mlainez/midiboard/docs/render-3d.png

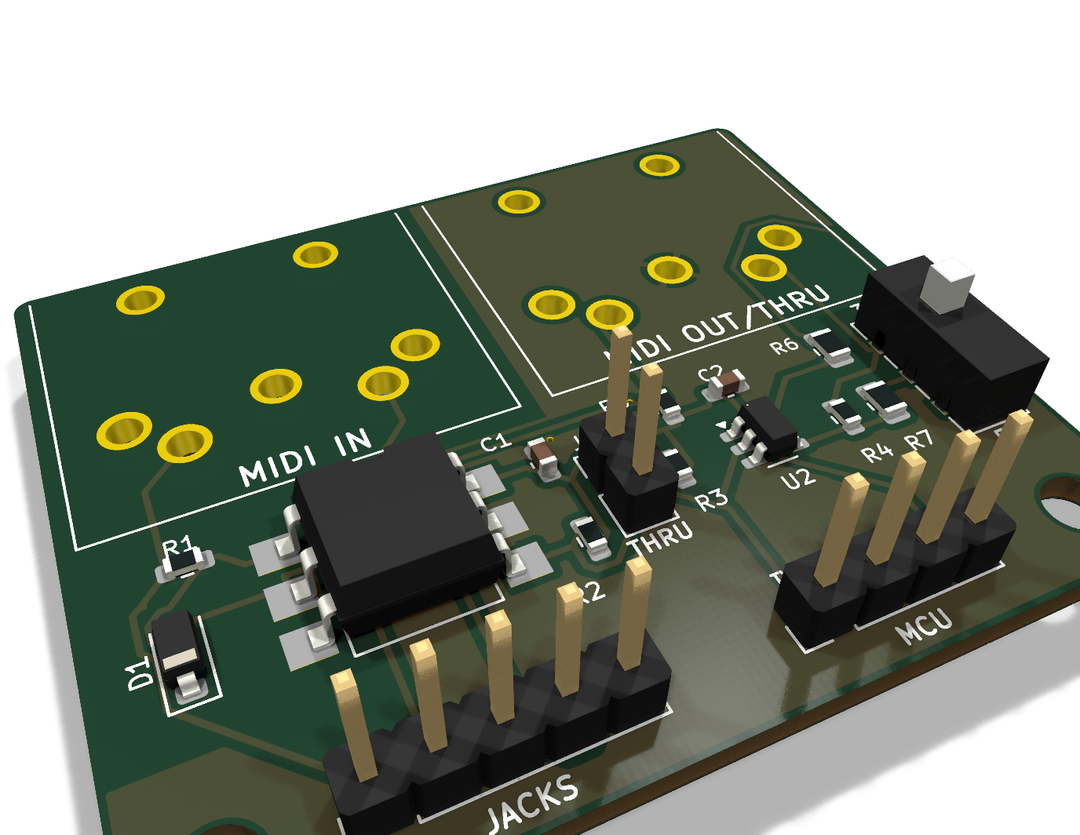
docs/render-3d.png
