mlainez/midiboard/docs/render-bottom.png

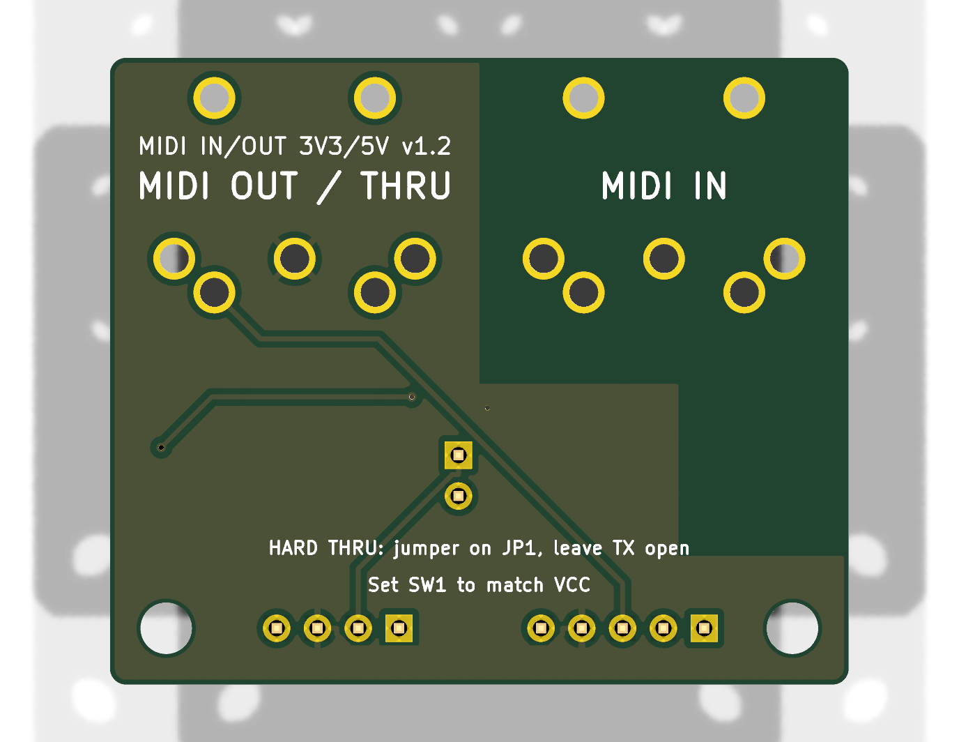
docs/render-bottom.png
