mlainez/midiboard/jlcpcb/midiboard-BOM.csv

Comment | Designator | Footprint | LCSC Part #
100nF | C1,C2 | C_0603_1608Metric | C14663
1N4148W | D1 | D_SOD-123 | C81598
220 | R1,R4,R5 | R_0603_1608Metric | C22962
470 | R2 | R_0603_1608Metric | C23179
10k | R3 | R_0603_1608Metric | C25804
33 | R6 | R_0805_2012Metric | C17634
10 | R7 | R_0805_2012Metric | C17415
3V3/5V | SW1 | SW_DPDT_CK_JS202011JCQN | C221665
H11L1SM | U1 | SMDIP-6_W9.53mm | C899473
74LVC1G17 | U2 | SOT-23-5 | C151394
