mlainez/midiboard/jlcpcb/midiboard-schematic.pdf

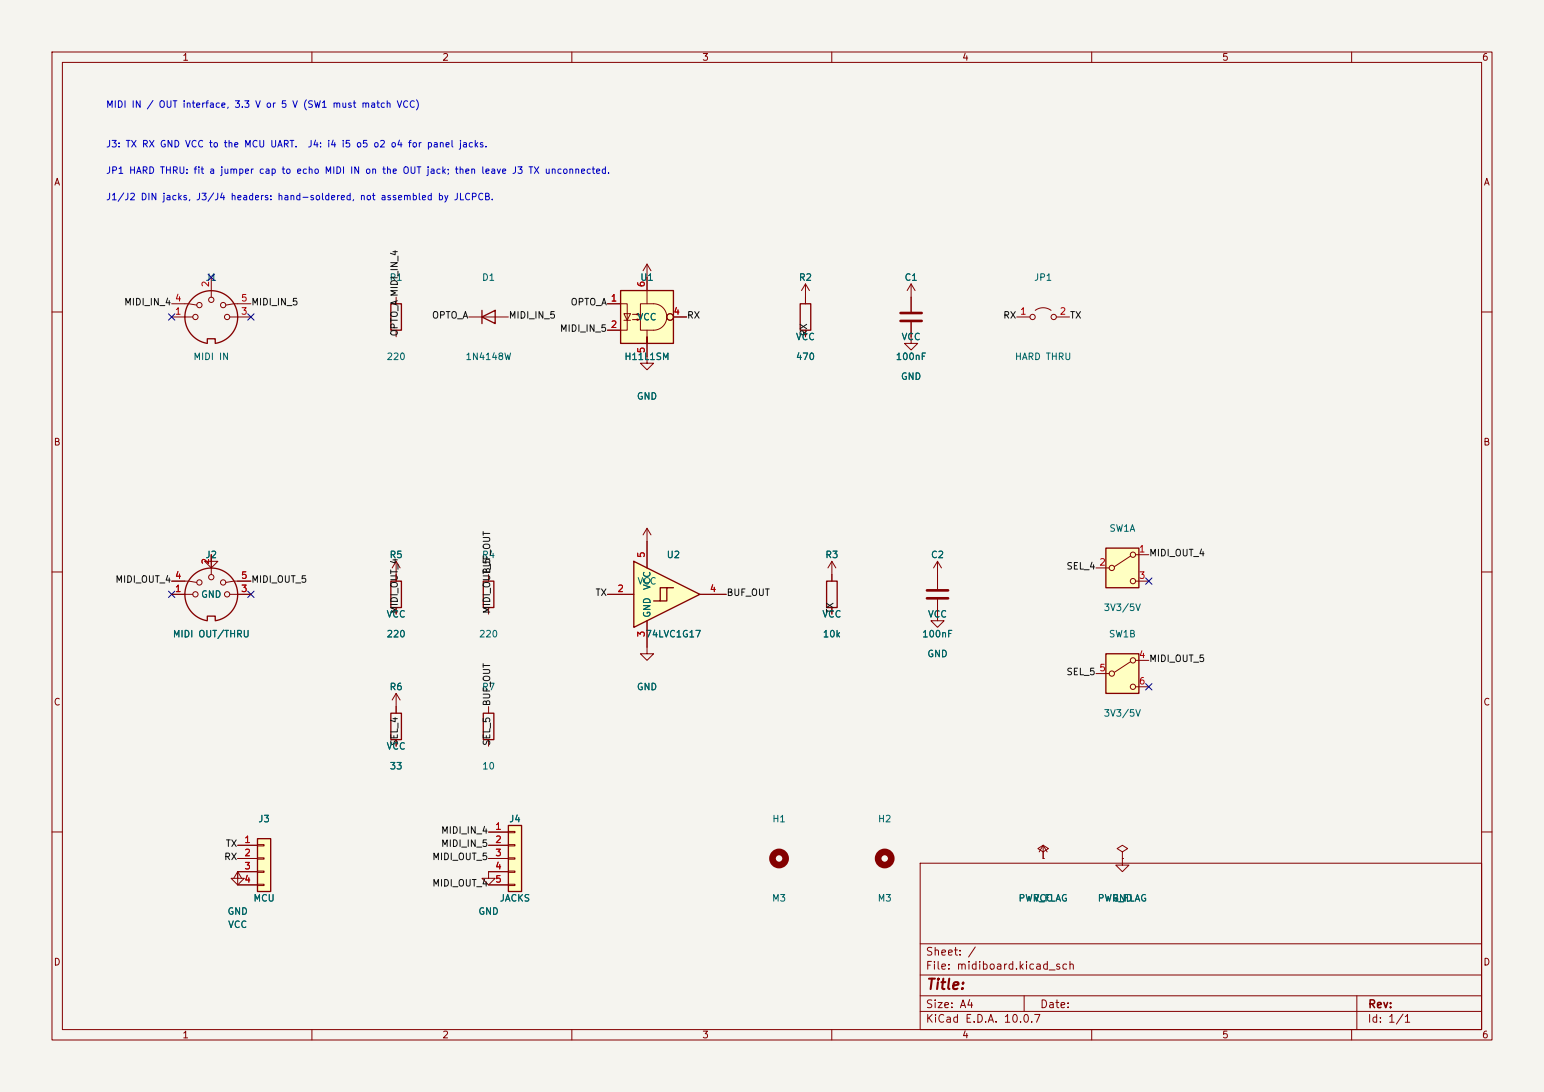
[picture p4: page 1]

TX MIDI IN / OUT interface, 3.3 V or 5 V (SW1 must match VCC) J3: TX RX GND VCC to the MCU UART. J4: i4 i5 o5 o2 o4 for panel jacks. JP1 HARD THRU: fit a jumper cap to echo MIDI IN on the OUT jack; then leave J3 TX unconnected. J1/J2 DIN jacks, J3/J4 headers: hand-soldered, not assembled by JLCPCB. J2 MIDI OUT/THRU

Size: A4 | Rev:
KiCad E.D.A. 10.0.7 | Id: 1/1
