mlainez/midiboard/midiboard.kicad_pcb

## KiCad design midiboard.kicad_pcb (2026-10-20)

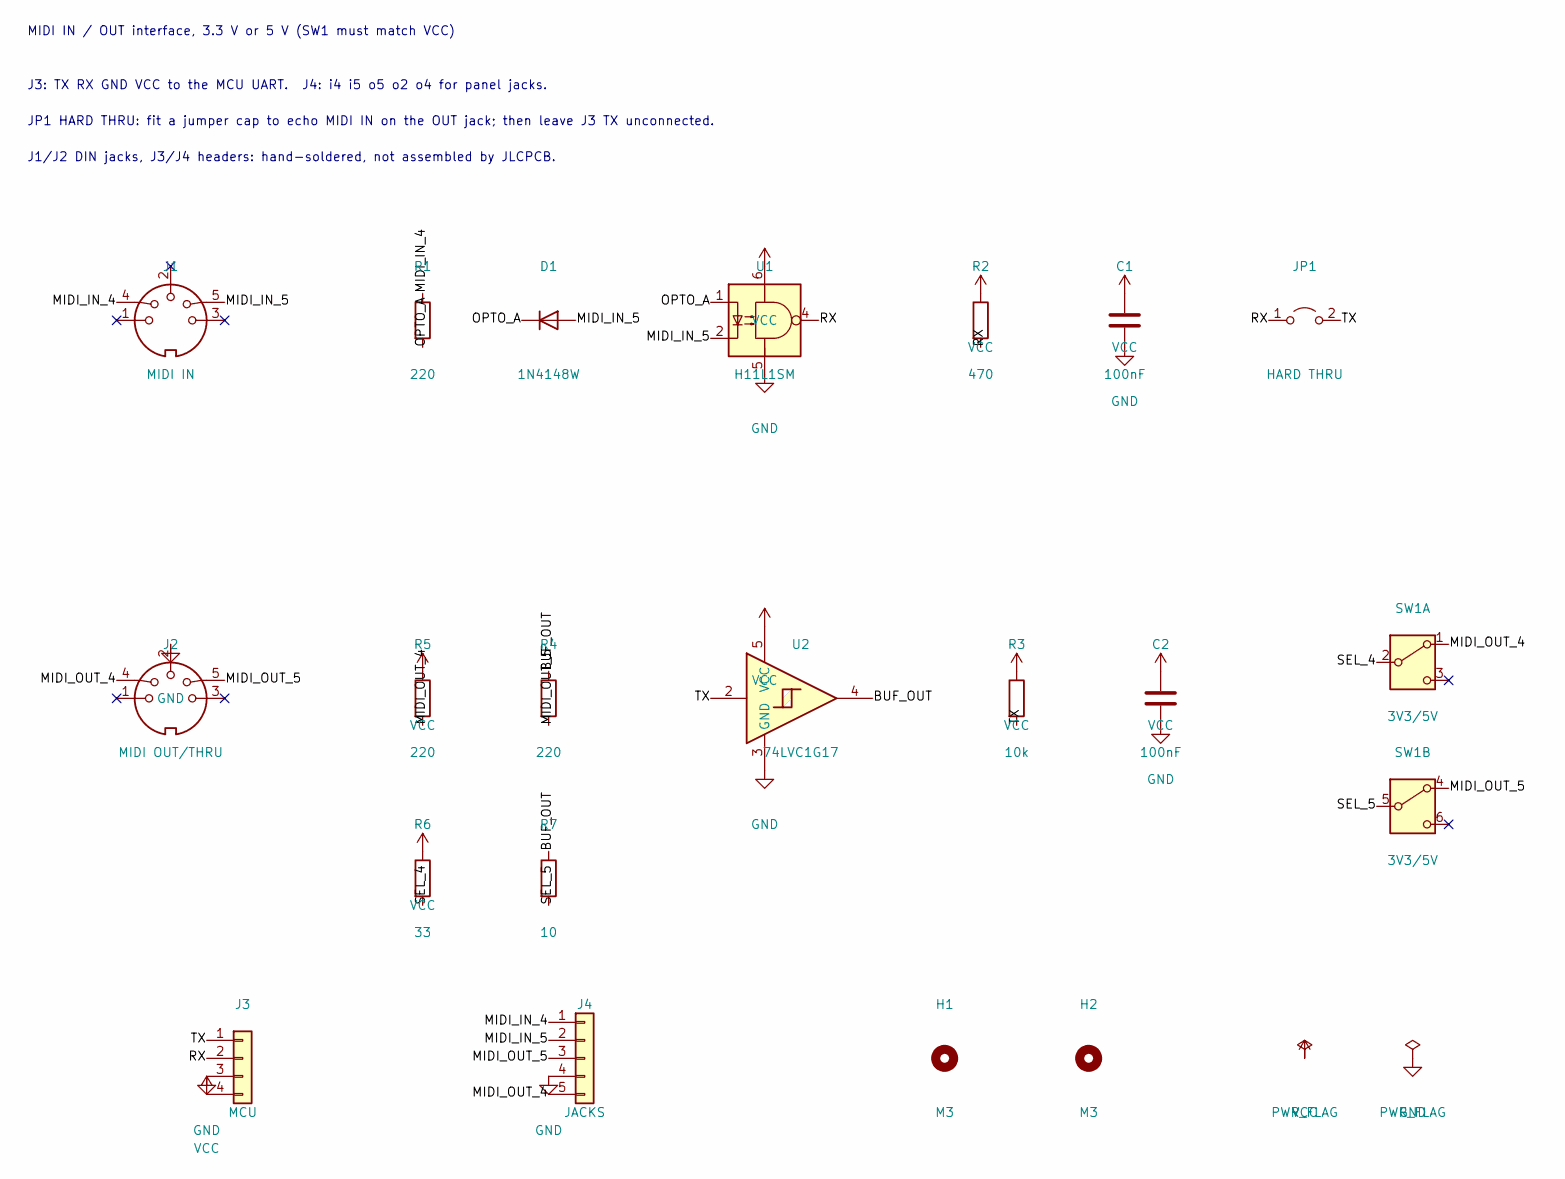
[picture p5: schematic midiboard.kicad_sch]

Parts:
C1, C2: 100nF; C_0603_1608Metric; MPN CC0603KRX7R9BB104; LCSC C14663
D1: 1N4148W; D_SOD-123; MPN 1N4148W; LCSC C81598
H1, H2: M3; MountingHole_3.2mm_M3
J1: MIDI IN; DIN-5_Female_Horizontal_DIN-504; MPN Legion DIN-504 (LCSC C23689428)
J2: MIDI OUT/THRU; DIN-5_Female_Horizontal_DIN-504; MPN Legion DIN-504 (LCSC C23689428)
J3: MCU; PinHeader_1x04_P2.54mm_Vertical; MPN 2.54mm pin header 1x4
J4: JACKS; PinHeader_1x05_P2.54mm_Vertical; MPN 2.54mm pin header 1x5
JP1: HARD THRU; PinHeader_1x02_P2.54mm_Vertical; MPN 2.54mm pin header 1x2 + jumper cap
R1, R4, R5: 220; R_0603_1608Metric; MPN 0603WAF2200T5E; LCSC C22962
R2: 470; R_0603_1608Metric; MPN 0603WAF4700T5E; LCSC C23179
R3: 10k; R_0603_1608Metric; MPN 0603WAF1002T5E; LCSC C25804
R6: 33; R_0805_2012Metric; MPN 0805W8F330JT5E; LCSC C17634
R7: 10; R_0805_2012Metric; MPN 0805W8F100JT5E; LCSC C17415
SW1: 3V3/5V; SW_DPDT_CK_JS202011JCQN; MPN C&K JS202011JCQN; LCSC C221665
U1: H11L1SM; SMDIP-6_W9.53mm; MPN onsemi H11L1SM; LCSC C899473
U2: 74LVC1G17; SOT-23-5; MPN Diodes 74LVC1G17W5-7; LCSC C151394

Connections:
/BUF_OUT: R4.1, R7.1, U2.4
/MIDI_IN_4: J1.4, J4.1, R1.1
/MIDI_IN_5: D1.2 (A), J1.5, J4.2, U1.2
/MIDI_OUT_4: J2.4, J4.5, R5.2, SW1.1 (A)
/MIDI_OUT_5: J2.5, J4.3, R4.2, SW1.4 (A)
/OPTO_A: D1.1 (K), R1.2, U1.1
/RX: J3.2, JP1.1 (A), R2.2, U1.4
/SEL_4: R6.2, SW1.2 (B)
/SEL_5: R7.2, SW1.5 (B)
/TX: J3.1, JP1.2 (B), R3.2, U2.2
GND: C1.2, C2.2, J2.2, J3.3, J4.4, U1.5, U2.3 (GND)
VCC: C1.1, C2.1, J3.4, R2.1, R3.1, R5.1, R6.1, U1.6, U2.5 (VCC)

Notes on the sheet:
MIDI IN / OUT interface, 3.3 V or 5 V (SW1 must match VCC)
J3: TX RX GND VCC to the MCU UART. J4: i4 i5 o5 o2 o4 for panel jacks.
JP1 HARD THRU: fit a jumper cap to echo MIDI IN on the OUT jack; then leave J3 TX unconnected.
J1/J2 DIN jacks, J3/J4 headers: hand-soldered, not assembled by JLCPCB.

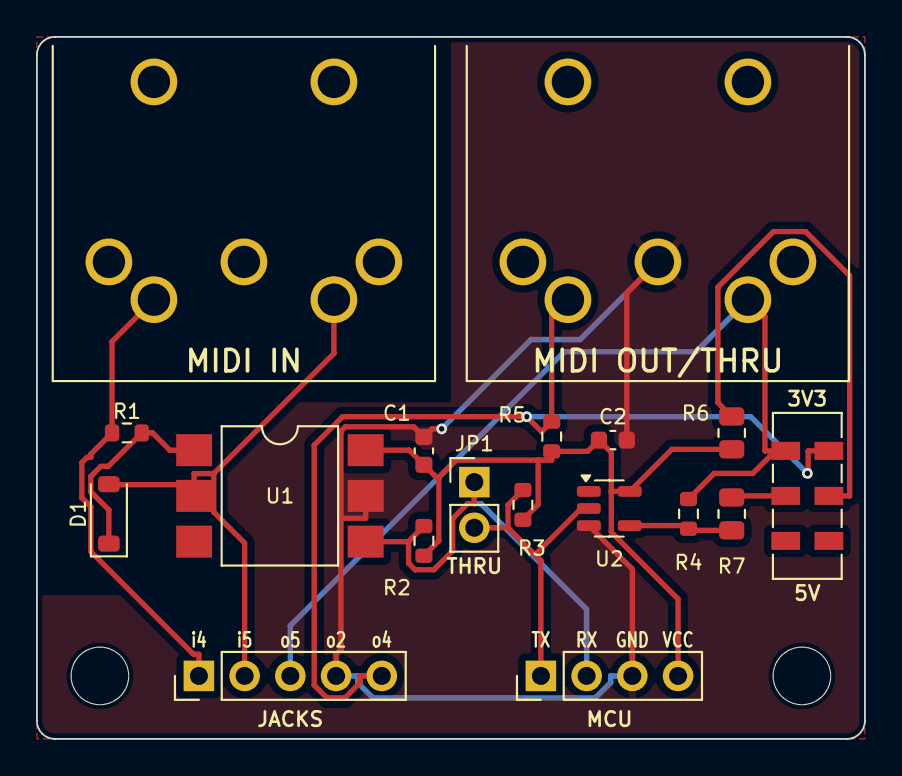
[picture p6: board midiboard.kicad_pcb from above]

Board: 2 copper layers, 46.0 x 39.0 mm, 20 parts (0 on the bottom side), 12 nets.
